rcludwick/Macropad5x5/3d/kicad models/PEC11L-4115F-S0020.stp

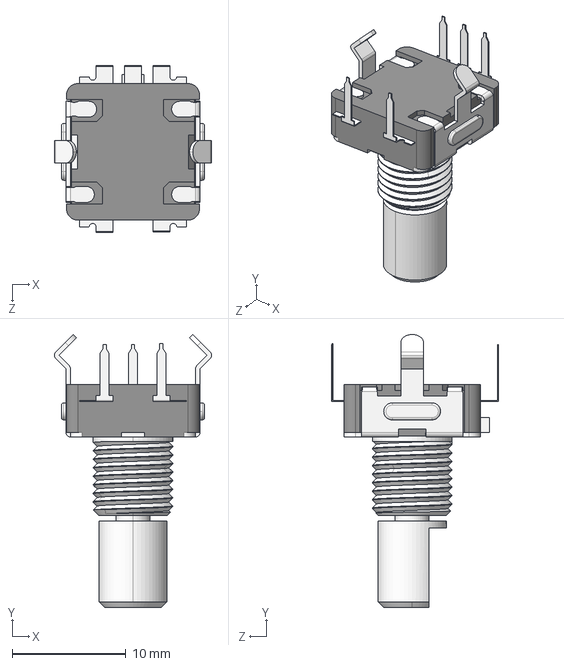
[picture p1: CAD file, 2024-10-01]
3d/kicad models/PEC11L-4115F-S0020.stp
13.8 x 24.0 x 14.7 mm
