rcludwick/Macropad5x5/3d/RotaryEncoderCoverV64.3mf

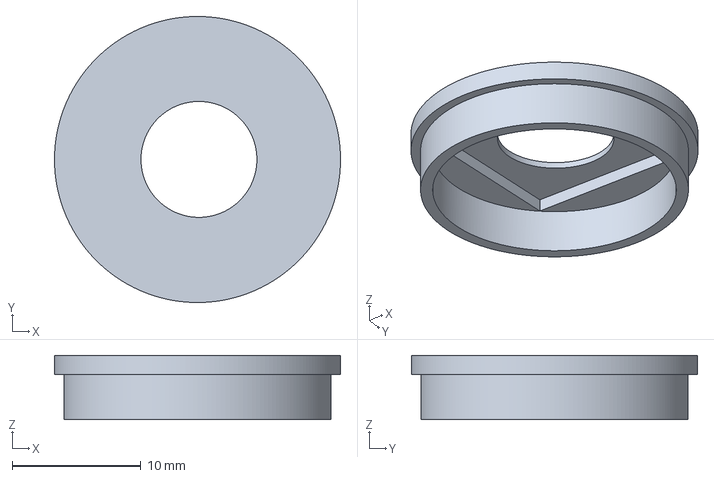
[picture p2: CAD file, 2024-10-01]
3d/RotaryEncoderCoverV64.3mf
22.2 x 22.2 x 5.00 mm
