rcludwick/Macropad5x5/Macropad5x5.step

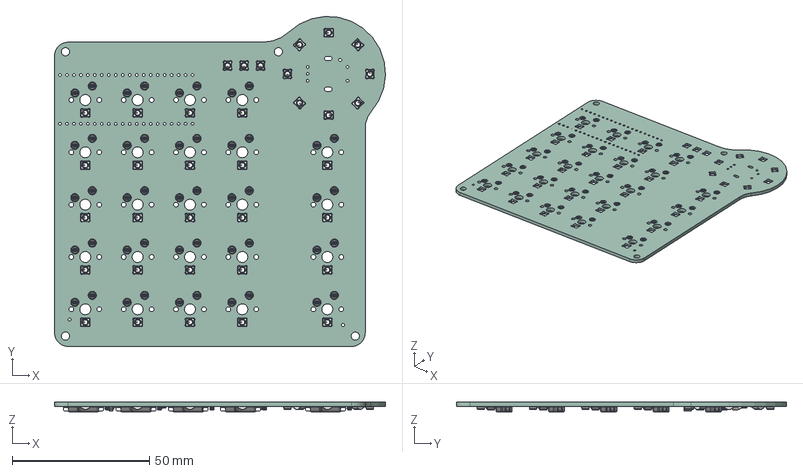
[picture p3: CAD file, 2024-07-22]
Macropad5x5.step
120.5 x 120.1 x 3.47 mm
D_SOD_123 x 25
LED_SK6812MINI-E v1 x 35
Kailh Hotswap RightVersion v23 x 24
C_0805_2012Metric x 2
R_0805_2012Metric x 2
SOT_23_5
Macropad5x5_PCB
