rcludwick/Macropad5x5/3d/kicad models/TS-1187A-B-A-B--3DModel-STEP-56544.STEP

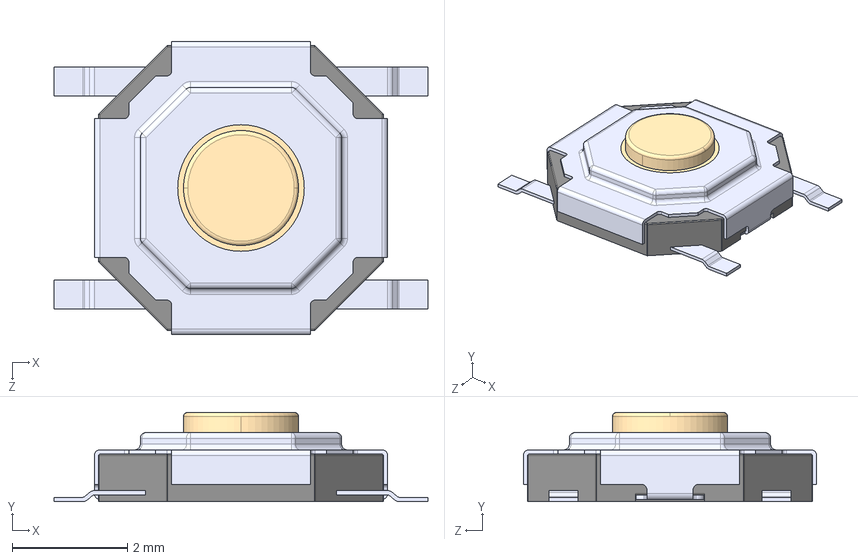
[picture p4: CAD file, 2024-10-01]
3d/kicad models/TS-1187A-B-A-B--3DModel-STEP-56544.STEP
6.50 x 1.55 x 5.10 mm
