rcludwick/Macropad5x5/3d/LightPipesV64.3mf

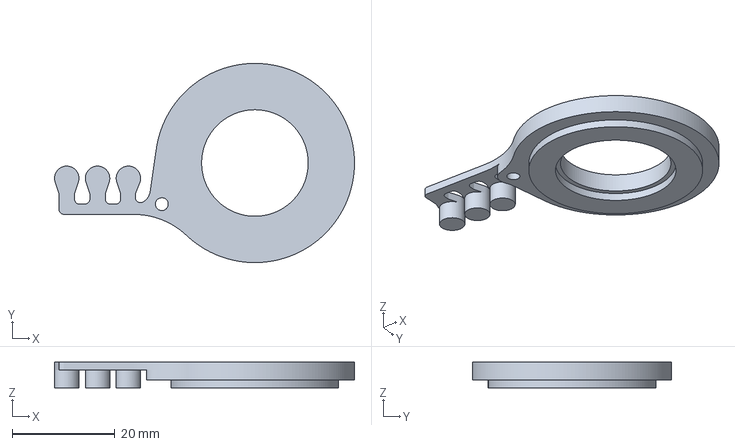
[picture p5: CAD file, 2024-10-01]
3d/LightPipesV64.3mf
58.4 x 38.8 x 5.00 mm
