rcludwick/Macropad5x5/3d/KeySwitchPlateV64.3mf

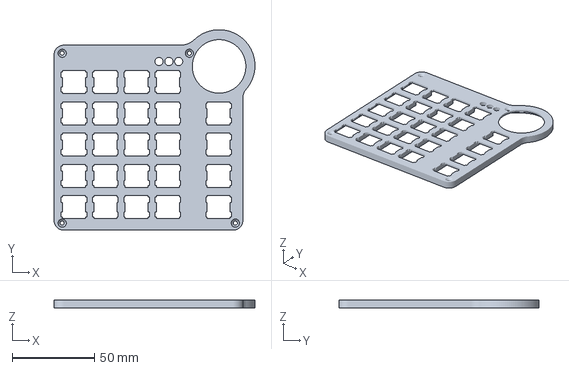
[picture p6: CAD file, 2024-10-01]
3d/KeySwitchPlateV64.3mf
122.5 x 122.2 x 5.00 mm
