rcludwick/Macropad5x5/3d/kicad models/EC11-THT-20F-black.step

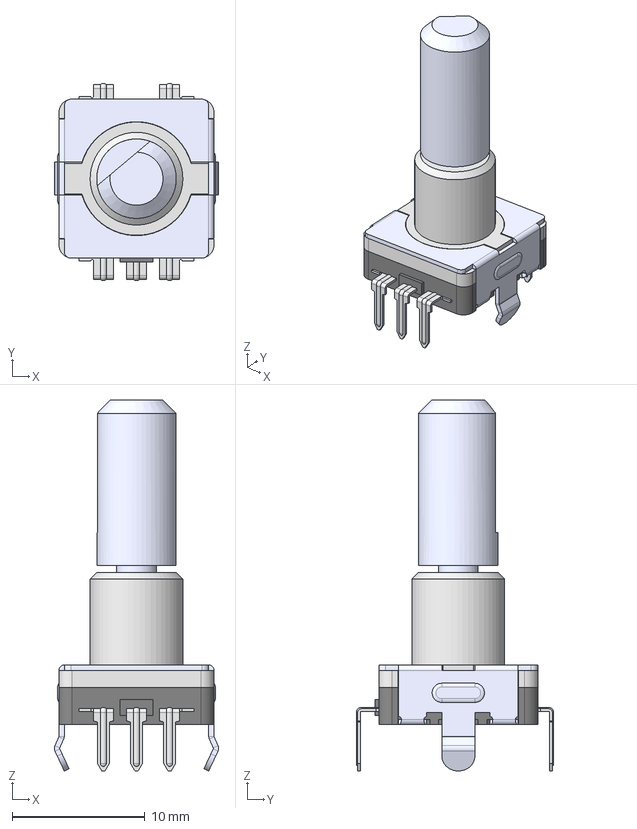
[picture p7: CAD file, 2024-10-01]
3d/kicad models/EC11-THT-20F-black.step
12.4 x 14.9 x 28.0 mm
Lb7
20F
EC11-Housing-THT
