rcludwick/Macropad5x5/3d/kicad models/cherry-mx-switch.step

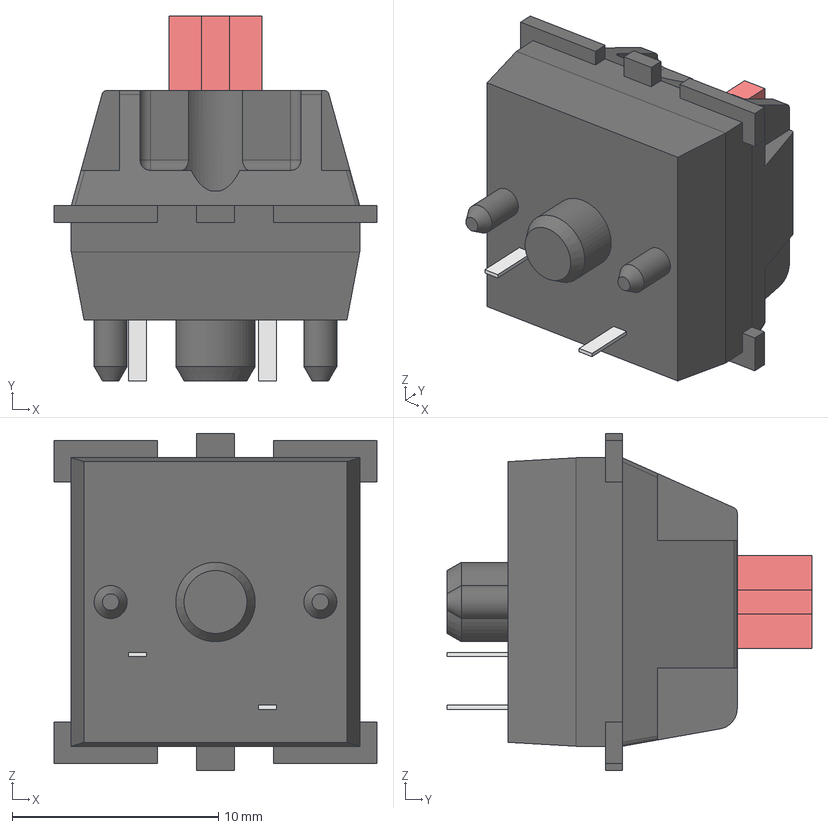
[picture p8: CAD file, 2024-07-30]
3d/kicad models/cherry-mx-switch.step
15.6 x 17.7 x 16.3 mm
