rcludwick/Macropad5x5/3d/RotaryEncoderNutV64.3mf

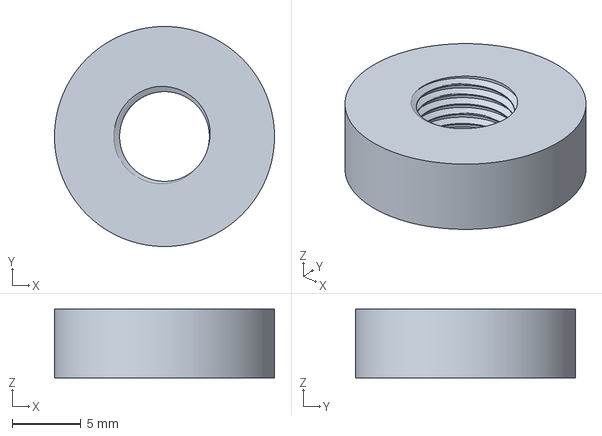
[picture p9: CAD file, 2024-10-01]
3d/RotaryEncoderNutV64.3mf
16.0 x 16.0 x 5.02 mm
