rcludwick/Macropad5x5/3d/CaseBottomV65.3mf

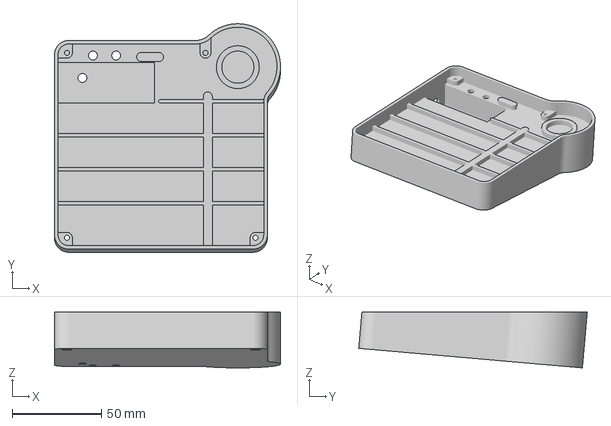
[picture p10: CAD file, 2024-10-01]
3d/CaseBottomV65.3mf
126.5 x 127.9 x 31.2 mm
