rcludwick/Macropad5x5/3d/kicad models/R5_1u.step

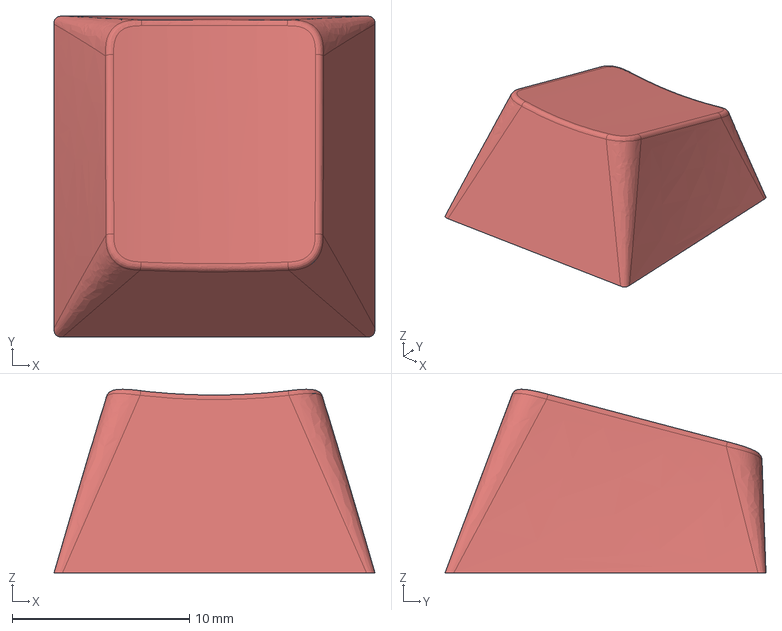
[picture p11: CAD file, 2024-07-30]
3d/kicad models/R5_1u.step
18.1 x 18.1 x 10.3 mm
