rcludwick/Macropad5x5/3d/kicad models/R5_1.25u.step

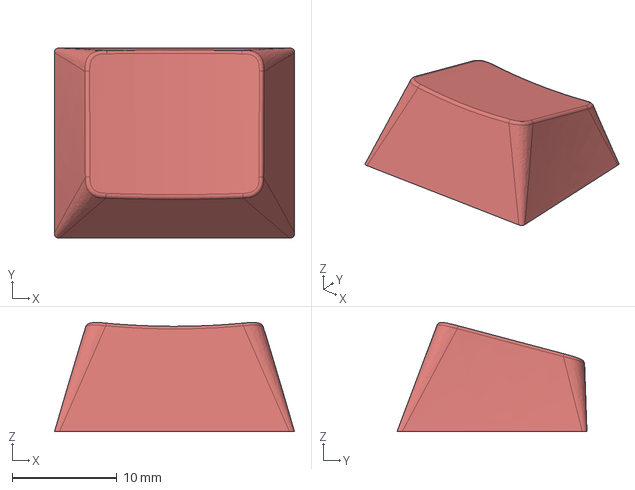
[picture p12: CAD file, 2024-07-30]
3d/kicad models/R5_1.25u.step
22.9 x 18.1 x 10.4 mm
