rcludwick/Macropad5x5/Macropad5x5.kicad_pcb

## KiCad design Macropad5x5.kicad_pcb (2024-10-01)

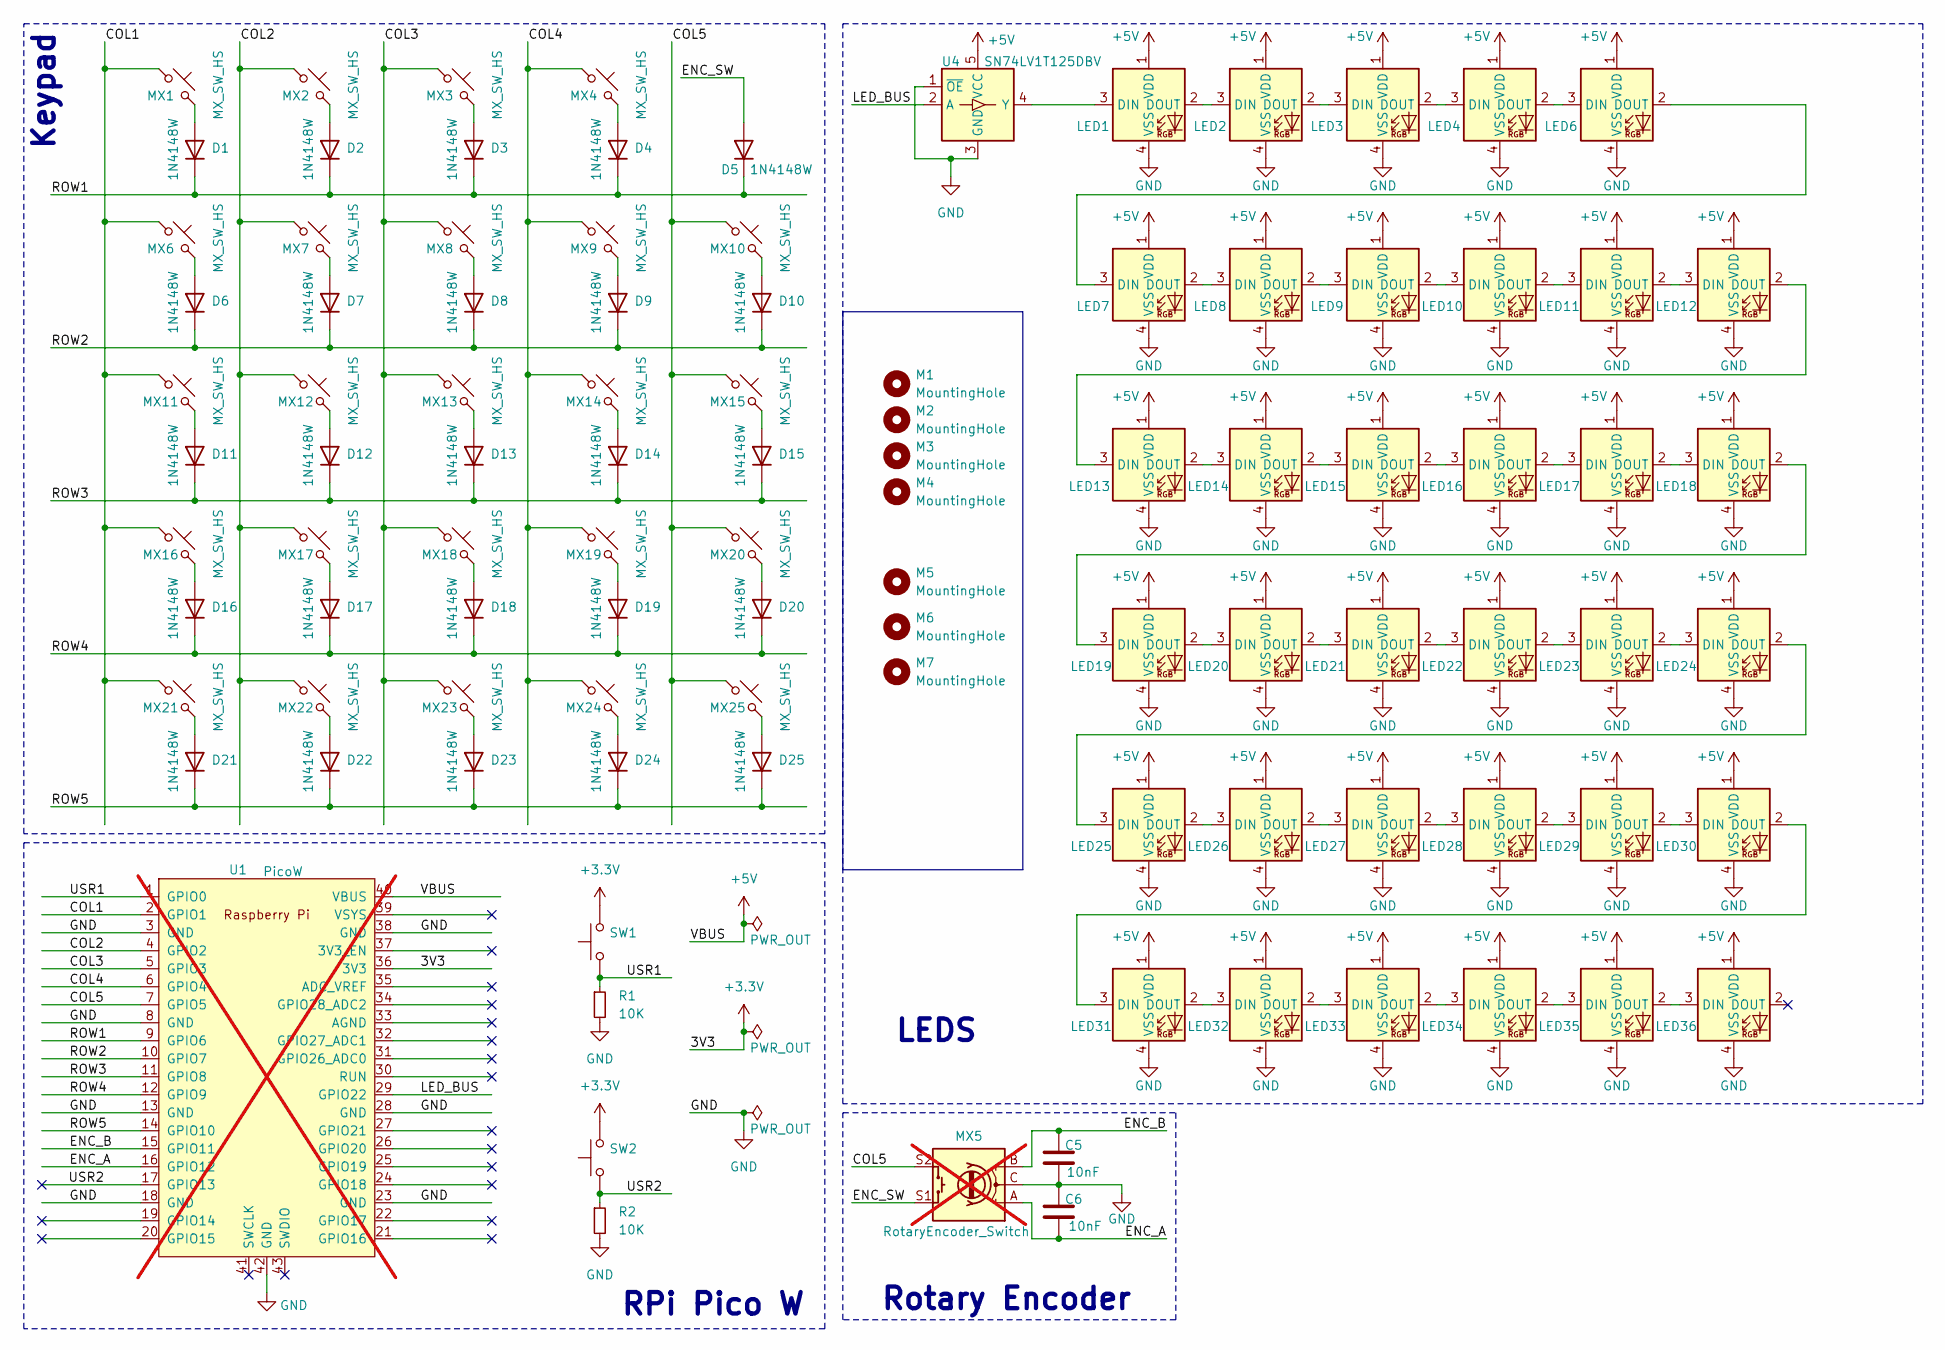
[picture p13: schematic Macropad5x5.kicad_sch, Macropad 5x5]

Parts:
C5, C6: 10nF; C_0805_2012Metric; LCSC C1710
D1, D2, D3, D4, D5, D6, D7, D8, D9, D10, D11, D12, D13, D14, D15, D16, D17, D18, D19, D20, D21, D22, D23, D24, D25: 1N4148W; D_SOD-123; LCSC C81598
LED1, LED2, LED3, LED4, LED6, LED7, LED8, LED9, LED10, LED11, LED12, LED13, LED14, LED15, LED16, LED17, LED18, LED19, LED20, LED21, LED22, LED23, LED24, LED25, LED26, LED27, LED28, LED29, LED30, LED31, LED32, LED33, LED34, LED35, LED36: choc_SK6812MINI-E; LED_choc_6028R; LCSC C5378731
M1, M2, M3, M4: MountingHole; MountingHole_3mm
M5, M6, M7: MountingHole; JLCPCB_Tooling_Hole
MX1, MX2, MX3, MX4, MX6, MX7, MX8, MX9, MX11, MX12, MX13, MX14, MX16, MX17, MX18, MX19, MX21, MX22, MX23, MX24: MX_SW_HS; SW_Cherry_MX_PCB_1.00u; LCSC C5156480
MX5: RotaryEncoder_Switch; RotaryEncoder_Alps_EC11E-Switch_Vertical_H20mm; not fitted
MX10, MX15, MX20, MX25: MX_SW_HS; SW_Cherry_MX_PCB_1.25u; LCSC C5156480
R1, R2: 10K; R_0805_2012Metric; LCSC C17414
SW1, SW2: SW_Push; SW_Push_1P1T_XKB_TS-1187A; LCSC C318884
U1: PicoW; RPi_PicoW_SMD_TH_NOSWD; not fitted
U4: SN74LV1T125DBV; SOT-23-5; LCSC C473338

Connections:
+3.3V: SW1.2, SW2.2, U1.36 (3V3)
+5V: LED1.1 (VDD), LED2.1 (VDD), LED3.1 (VDD), LED4.1 (VDD), LED6.1 (VDD), LED7.1 (VDD), LED8.1 (VDD), LED9.1 (VDD), LED10.1 (VDD), LED11.1 (VDD), LED12.1 (VDD), LED13.1 (VDD), LED14.1 (VDD), LED15.1 (VDD), LED16.1 (VDD), LED17.1 (VDD), LED18.1 (VDD), LED19.1 (VDD), LED20.1 (VDD), LED21.1 (VDD), LED22.1 (VDD), LED23.1 (VDD), LED24.1 (VDD), LED25.1 (VDD), LED26.1 (VDD), LED27.1 (VDD), LED28.1 (VDD), LED29.1 (VDD), LED30.1 (VDD), LED31.1 (VDD), LED32.1 (VDD), LED33.1 (VDD), LED34.1 (VDD), LED35.1 (VDD), LED36.1 (VDD), U1.40 (VBUS), U4.5 (VCC)
/COL1: MX1.1, MX6.1, MX11.1, MX16.1, MX21.1, U1.2 (GPIO1)
/COL2: MX2.1, MX7.1, MX12.1, MX17.1, MX22.1, U1.4 (GPIO2)
/COL3: MX3.1, MX8.1, MX13.1, MX18.1, MX23.1, U1.5 (GPIO3)
/COL4: MX4.1, MX9.1, MX14.1, MX19.1, MX24.1, U1.6 (GPIO4)
/COL5: MX5.S2, MX10.1, MX15.1, MX20.1, MX25.1, U1.7 (GPIO5)
/ENC_A: C6.2, MX5.A, U1.16 (GPIO12)
/ENC_B: C5.1, MX5.B, U1.15 (GPIO11)
/ENC_SW: D5.2 (A), MX5.S1
/LED_BUS: U1.29 (GPIO22), U4.2 (A)
/ROW1: D1.1 (K), D2.1 (K), D3.1 (K), D4.1 (K), D5.1 (K), U1.9 (GPIO6)
/ROW2: D6.1 (K), D7.1 (K), D8.1 (K), D9.1 (K), D10.1 (K), U1.10 (GPIO7)
/ROW3: D11.1 (K), D12.1 (K), D13.1 (K), D14.1 (K), D15.1 (K), U1.11 (GPIO8)
/ROW4: D16.1 (K), D17.1 (K), D18.1 (K), D19.1 (K), D20.1 (K), U1.12 (GPIO9)
/ROW5: D21.1 (K), D22.1 (K), D23.1 (K), D24.1 (K), D25.1 (K), U1.14 (GPIO10)
/USR1: R1.1, SW1.1, U1.1 (GPIO0)
/USR2: R2.1, SW2.1, U1.17 (GPIO13)
GND: C5.2, C6.1, LED1.4 (VSS), LED2.4 (VSS), LED3.4 (VSS), LED4.4 (VSS), LED6.4 (VSS), LED7.4 (VSS), LED8.4 (VSS), LED9.4 (VSS), LED10.4 (VSS), LED11.4 (VSS), LED12.4 (VSS), LED13.4 (VSS), LED14.4 (VSS), LED15.4 (VSS), LED16.4 (VSS), LED17.4 (VSS), LED18.4 (VSS), LED19.4 (VSS), LED20.4 (VSS), LED21.4 (VSS), LED22.4 (VSS), LED23.4 (VSS), LED24.4 (VSS), LED25.4 (VSS), LED26.4 (VSS), LED27.4 (VSS), LED28.4 (VSS), LED29.4 (VSS), LED30.4 (VSS), LED31.4 (VSS), LED32.4 (VSS), LED33.4 (VSS), LED34.4 (VSS), LED35.4 (VSS), LED36.4 (VSS), MX5.C, R1.2, R2.2, U1.3 (GND), U1.8 (GND), U1.13 (GND), U1.18 (GND), U1.23 (GND), U1.28 (GND), U1.38 (GND), U1.42 (GND), U4.1 (~OE), U4.3 (GND)
unnamed: D1.2 (A), MX1.2
unnamed: D2.2 (A), MX2.2
unnamed: D3.2 (A), MX3.2
unnamed: D4.2 (A), MX4.2
unnamed: D6.2 (A), MX6.2
unnamed: D7.2 (A), MX7.2
unnamed: D8.2 (A), MX8.2
unnamed: D9.2 (A), MX9.2
unnamed: D10.2 (A), MX10.2
unnamed: D11.2 (A), MX11.2
unnamed: D12.2 (A), MX12.2
unnamed: D13.2 (A), MX13.2
unnamed: D14.2 (A), MX14.2
unnamed: D15.2 (A), MX15.2
unnamed: D16.2 (A), MX16.2
unnamed: D17.2 (A), MX17.2
unnamed: D18.2 (A), MX18.2
unnamed: D19.2 (A), MX19.2
unnamed: D20.2 (A), MX20.2
unnamed: D21.2 (A), MX21.2
unnamed: D22.2 (A), MX22.2
unnamed: D23.2 (A), MX23.2
unnamed: D24.2 (A), MX24.2
unnamed: D25.2 (A), MX25.2
unnamed: LED1.3 (DIN), U4.4 (Y)
unnamed: LED1.2 (DOUT), LED2.3 (DIN)
unnamed: LED2.2 (DOUT), LED3.3 (DIN)
unnamed: LED3.2 (DOUT), LED4.3 (DIN)
unnamed: LED4.2 (DOUT), LED6.3 (DIN)
unnamed: LED6.2 (DOUT), LED7.3 (DIN)
unnamed: LED7.2 (DOUT), LED8.3 (DIN)
unnamed: LED8.2 (DOUT), LED9.3 (DIN)
unnamed: LED9.2 (DOUT), LED10.3 (DIN)
unnamed: LED10.2 (DOUT), LED11.3 (DIN)
unnamed: LED11.2 (DOUT), LED12.3 (DIN)
unnamed: LED12.2 (DOUT), LED13.3 (DIN)
unnamed: LED13.2 (DOUT), LED14.3 (DIN)
unnamed: LED14.2 (DOUT), LED15.3 (DIN)
unnamed: LED15.2 (DOUT), LED16.3 (DIN)
unnamed: LED16.2 (DOUT), LED17.3 (DIN)
unnamed: LED17.2 (DOUT), LED18.3 (DIN)
unnamed: LED18.2 (DOUT), LED19.3 (DIN)
unnamed: LED19.2 (DOUT), LED20.3 (DIN)
unnamed: LED20.2 (DOUT), LED21.3 (DIN)
unnamed: LED21.2 (DOUT), LED22.3 (DIN)
unnamed: LED22.2 (DOUT), LED23.3 (DIN)
unnamed: LED23.2 (DOUT), LED24.3 (DIN)
unnamed: LED24.2 (DOUT), LED25.3 (DIN)
unnamed: LED25.2 (DOUT), LED26.3 (DIN)
unnamed: LED26.2 (DOUT), LED27.3 (DIN)
unnamed: LED27.2 (DOUT), LED28.3 (DIN)
unnamed: LED28.2 (DOUT), LED29.3 (DIN)
unnamed: LED29.2 (DOUT), LED30.3 (DIN)
unnamed: LED30.2 (DOUT), LED31.3 (DIN)
unnamed: LED31.2 (DOUT), LED32.3 (DIN)
unnamed: LED32.2 (DOUT), LED33.3 (DIN)
unnamed: LED33.2 (DOUT), LED34.3 (DIN)
unnamed: LED34.2 (DOUT), LED35.3 (DIN)
unnamed: LED35.2 (DOUT), LED36.3 (DIN)

Notes on the sheet:
LEDS
Rotary Encoder
Keypad
RPi Pico W

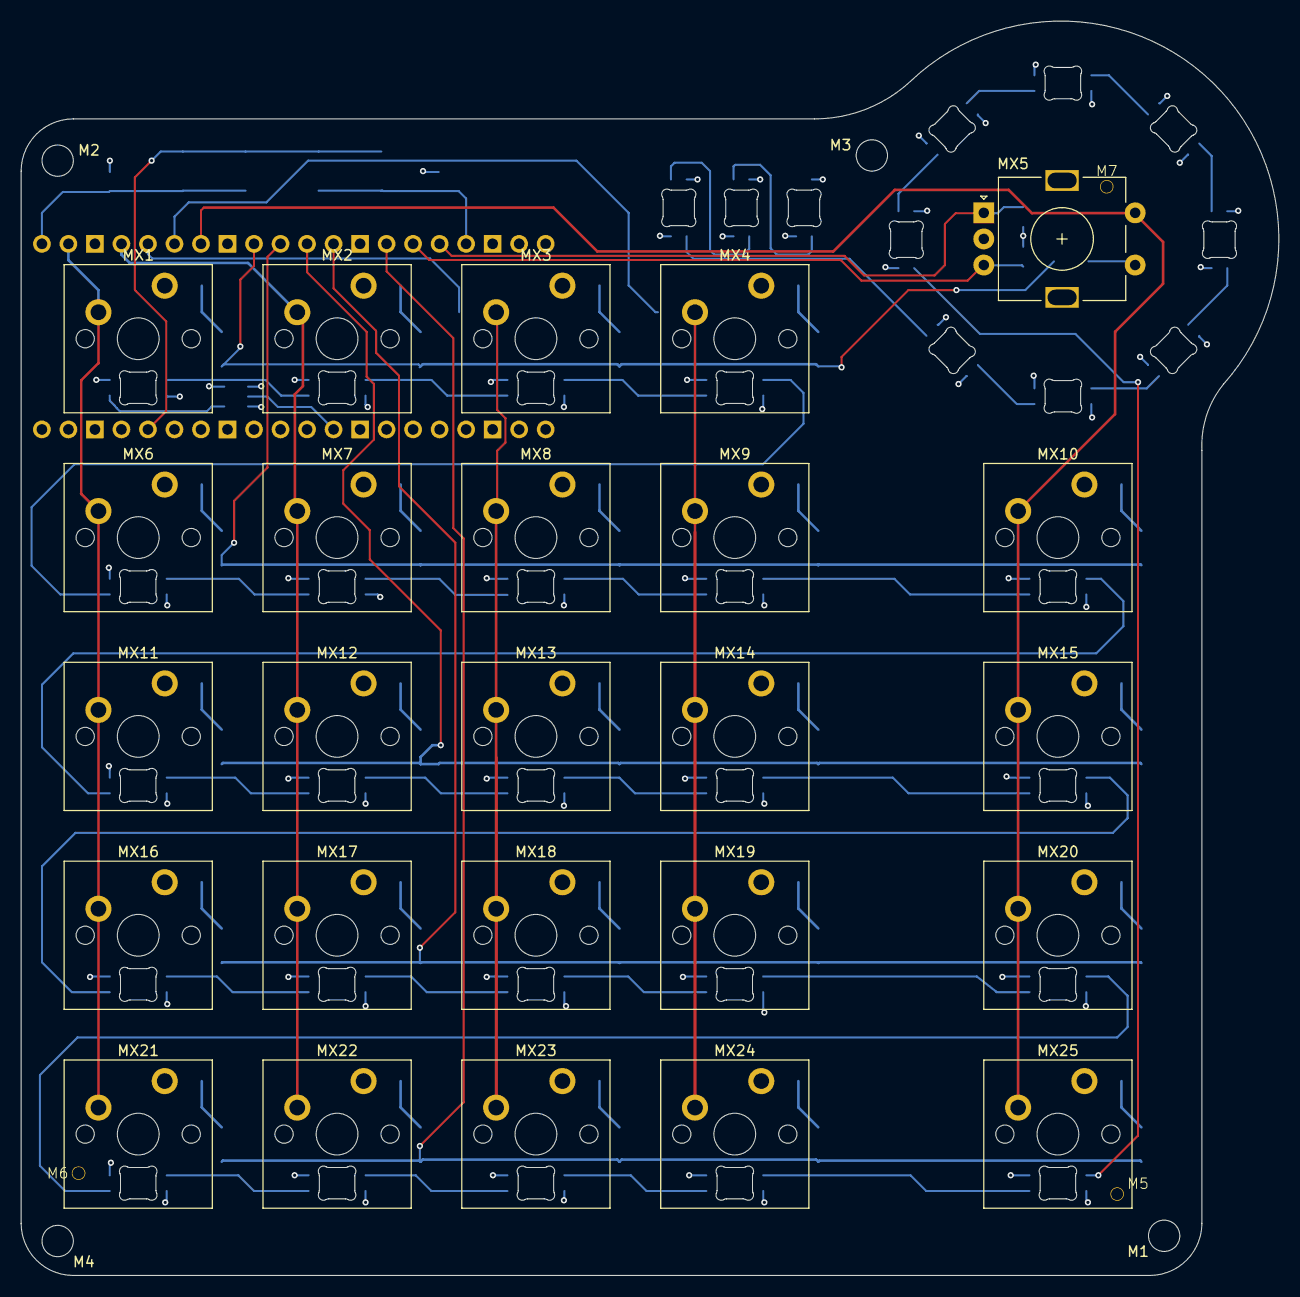
[picture p14: board Macropad5x5.kicad_pcb from above]

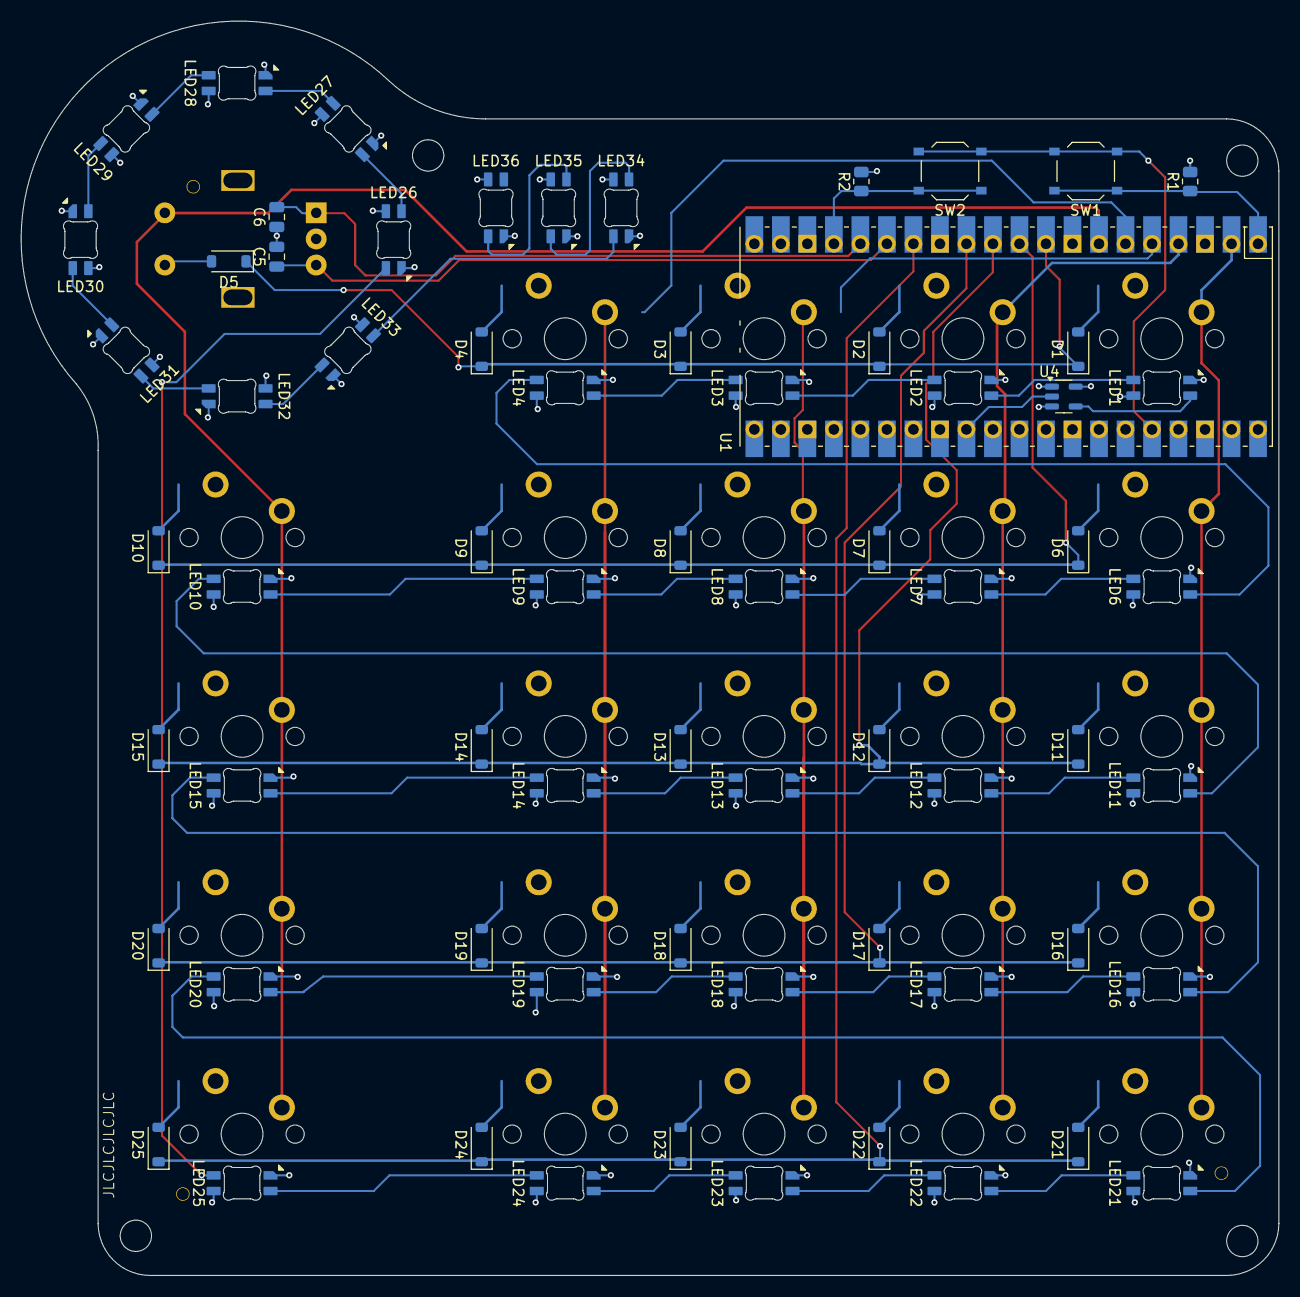
[picture p15: board Macropad5x5.kicad_pcb from below]

Board: 4 copper layers, 120.5 x 120.2 mm, 100 parts (68 on the bottom side), 78 nets.
