rcludwick/Macropad5x5/(commit log)

2024-07-22 Added step file for the macropad.
    [Macropad5x5.step]
2024-07-22 Minor change to tracks.
    [Macropad5x5.kicad_pcb]
2024-07-30 Updated 3d models.
    [Macropad5x5.kicad_pcb, Macropad5x5.kicad_sch, R5_1.25u.step, R5_1u.step, cherry-mx-switch.step]
2024-07-30 Updated schematic
2024-10-01 Updates and modifications
    [Macropad5x5.kicad_pcb]
2024-10-01 Updates and modifications. Added 3d models
    [CaseBottomV65.3mf, EC11-THT-20F-black.step, KeySwitchPlateV64.3mf, LightPipesV64.3mf, PEC11L-4115F-S0020.stp, R5_1.25u.step, R5_1u.step, RotaryEncoderCoverV64.3mf]
