rcludwick/Macropad5x5/(notices)

Notices in the files:
Macropad5x5.kicad_sch:
(c) 2024 Rob Ludwick
